Makdaam/857_controller/passthrough/passthrough.ino

#include <SoftwareSerial.h>
//based completly on Arduino SoftwareSerial tutorial
//CC SA
//https://www.arduino.cc/en/Tutorial/SoftwareSerialExample

SoftwareSerial mySerial(10, 11); // RX, TX

void setup() {
  // Open serial communications and wait for port to open:
  Serial.begin(57600);
  while (!Serial) {
    ; // wait for serial port to connect. Needed for native USB port only
  }


  Serial.println("Goodnight moon!");

  // set the data rate for the SoftwareSerial port
  mySerial.begin(9600);
}

void loop() { // run over and over
  if (mySerial.available()) {
    Serial.write(mySerial.read());
  }
  if (Serial.available()) {
    mySerial.write(Serial.read());
  }
}
