Makdaam/857_controller/(commit log)

2017-10-29 initialization of the button pin corrected
    [MCP.ino]
2017-10-29 schematics added
2017-10-29 corrected schematic
2017-10-29 correcting schematics once again
